eSpark-Backup/ptec-waterdispensingsystem/README.md

# PTEC - Water Dispensing System
The Water Dispensing System is essentially a circuit that will be installed water tanks and will enable the vendor to ensure correct delivery of water to the actual customer and will also measure the amount of water delivered. It will also be responsible to sync with cloud for customer verification and water dispensing statuses.

## Project Requirements
### Documents
#### [Complete Project Description](https://github.com/eSpark-Consultants/ptec-waterdispensingsystem/blob/main/docs/Upwork%20Project%20Description.pdf)
#### [Scope of Work Document](https://github.com/eSpark-Consultants/ptec-waterdispensingsystem/blob/main/docs/Modified%20Scope.pdf)
### Additional Points
* Our work scope will be limited to only designing circuit 2 in the Scope of Work Document
* All parts selection and engineering will be done by eSpark and client will review at the end. No parts selection is done by client.
* We need to take into account the humid and harsh conditions where this circuit will be placed and hence do parts selection accordingly.
* Circuit 2 will communicate with Circuit 1 over RS485 so necessary conversion should be given on Circuit 2.
* There will also be an LCD display on circuit 2 to display messages and notifications.
