eSpark-Backup/ptec-waterdispensingsystem/Deliverables/TFT-LCD-Side-PCB-v1.0/Renderings/2D_Bottom_View.PNG.png

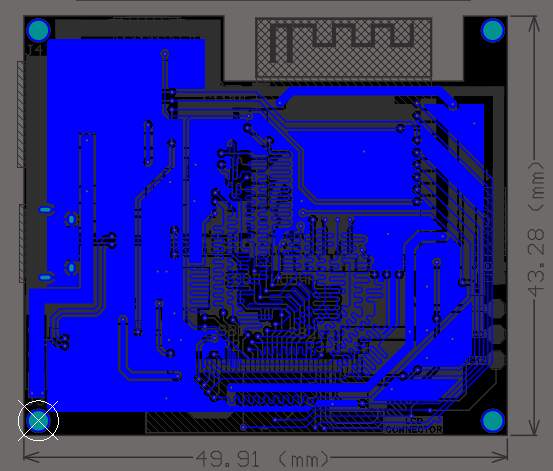
Deliverables/TFT-LCD-Side-PCB-v1.0/Renderings/2D_Bottom_View.PNG.png
