eSpark-Backup/ptec-waterdispensingsystem/Design Files/Main-PCB-v1.0/BOM/JLCPCB_BOM_v1.0.xlsx

Comment | Designator | Footprint | LCSC Part Number
CC0805KKX5R9BB225 | C1, C13, C25, C27 | Cap-0805 | C326581
CC0603KRX5R9BB104 | C2, C3, C10, C14, C16, C23, C24, C26, C32, C36, C37, C38, C42, C43, C44 | Cap-0603 | C386152
CC0603KRX5R6BB106 | C4, C6, C8, C18, C20, C21 | Cap-0603 | C326057
CC0603KRX5R8BB225 | C5, C11 | CAP-0603 | C309478
CC0603JRNPO9BN103 | C7 | Cap-0603 | C389113
UUD1H101MNL1GS | C9 | Custom | C116241
CC0402KRX7R9BB103 | C12, C15 | Cap-0402 | C60133
VUA270M1VTR-0606 | C17, C19 | Custom | C249807
CA45-A-10V-10uF-K | C22 | Custom | C128253
CC0603JRNPO9BN200 | C28, C29 | Cap-0603 | C105621
CC0603JRNPO9BN100 | C30, C31 | Cap-0603 | C106245
CC0402KRX5R7BB223 | C33, C34, C35, C39, C40, C41 | Cap-0402 | C147651
SK104C | D1 | SMC | C59500
SMBJ36CA | D2 | SMB_ | C556189
SK220-LTP | D3 | SMB_ | C725397
1N4148W-7-F | D4, D5, D6, D16, D17, D18 | SOD-123 | C83528
SMAJ6.5CA | D7, D8, D9, D10, D11, D12, D13, D14, D15, D19, D20, D21, D22, D23, D24, D25, D26, D27 | SMA | C83330
SHV2920P500-30-AA | F1 | Fuse-2920 | C495350
MF-MSMF010-2 | F2, F3, F4, F5, F6, F7, F8, F9, F10, F11, F12, F13 | Fuse-1812_ | C12430
B4B-XH-A(LF)(SN) | J2, J3, J4 | Custom | C144395
61300611121 | J5 | Custom | C37208
KH-2.54FH-1X8P-H8.5 | J6 | Custom | C2905417
B-2200S20P-A120 | J7 | Custom | C124410
JL762B-76202GA1 | J8, J9, J10, J11, J12, J13, J14, J15, J16, J17 | Custom | C394551
WJ500V-5.08-2P | J18 | Custom | C8465
1.25-5PWB | J19 | Custom | C2905012
YPRH1204-220M | L1 | Custom | C338845
YPRH1508-330M | L2 | Custom | C970542
SWPA8040S100MT | L3 | Custom | C37429
NCD0603G2 | LED1, LED2, LED3, LED4, LED5, LED6, LED7, LED8, LED9, LED10, LED11, LED12 | LED-0603 | C87326
PRT-10474 | P1 | Custom
3313J-1-103E | PT1 | Custom | C124616
RT0805BRD07422KL | R1 | RES-0805 | C865483
RT0402BRD0722K1L | R2, R4 | Res-0402 | C852648
RT0402BRD07162KL | R3 | Res-0402 | C852551
RT0402BRD0718K7L | R5 | Res-0402 | C723581
RT0402BRD076K98L | R6 | Res-0402 | C852901
RC0402FR-071KL | R7 | Res-0402 | C144789
RC0402FR-0710KL | R8, R15, R16, R23 | Res-0402 | C60490
RC0402FR-070RL | R9, R10, R11, R12, R13, R14, R17, R18, R19, R20, R21, R22, R36, R37, R38, R40, R42, R44, R45, R46, R47, R69, R70, R71, R73, R75, R77, R78, R79, R80 | Res-0402 | C106231
RC0402FR-074K7L | R24, R25, R26, R39, R41, R43, R51, R52, R53, R54, R55, R56, R57, R58, R59, R72, R74, R76, R84, R85, R86, R87, R88, R89 | Res-0402 | C105871
RC0402FR-072K4L | R27, R28, R29, R30, R31, R32, R60, R61, R62, R63, R64, R65 | Res-0402 | C112296
RC0402FR-0756KL | R33, R34, R35, R66, R67, R68 | Res-0402 | C114756
RC0603FR-07120RL | R48, R49, R50, R81, R82, R83 | Res-0603 | C114640
TS-1109S-C-B | SW1, SW2 | Custom | C381037
LMR51420YDDCR | U1, U4 | SOT-23-6 THIN | C5383002
SPX3819M5-L-3-3/TR | U2 | SOT-23-5 | C9055
LM2679SX-ADJ/NOPB | U3 | TO-263-7 | C2877272
STM32F413VGT6 | U5 | LQFP-100 | C1337293
TXB0108PWR | U6, U7 | TSSOP-20 | C53406
SN74HC04NSR | U8, U9, U10, U14, U15, U16 | 14-SOIC | C6812
SP3485EIM/TR | U11, U12, U13, U17, U18, U19 | SOP-8 | C519086
X322516MLB4SI | X1 | SMD3225-4P | C13738
NX3215SA-32.768K-STD-MUA-14 | X2 | Custom | C156244
