eSpark-Backup/ptec-waterdispensingsystem/Design Files/Main-PCB-v1.0/BOM/Client_BOM_v1.0.xlsx

 |  | Component list |  | Bill of Materials for Project [Main-PCB-v1.0.]
 |  | Source Data From: |  | Main-PCB-v1.0
 |  | Project: |  | Main-PCB-v1.0
 |  | Variant: |  | None
# | Item Type | Designator | Description | Footprint | Manufacturer Part Number | Alternate Part Number | Manufacturer | Value | Quantity | Remarks
1 | Capacitor | C1, C13, C25, C27 | CAP CER 2.2UF 50V X5R 0805 | Cap-0805 | CC0805KKX5R9BB225 | - | Yageo | 2.2uF | 4
2 | Capacitor | C2, C3, C10, C14, C16, C23, C24, C26, C32, C36, C37, C38, C42, C43, C44 | CAP CER 0.1UF 50V X5R 0603 | Cap-0603 | CC0603KRX5R9BB104 | - | Yageo | 100nF | 15
3 | Capacitor | C4, C6, C8, C18, C20, C21 | CAP CER 10UF 10V X5R 0603 | Cap-0603 | CC0603KRX5R6BB106 | - | Yageo | 10uF | 6
4 | Capacitor | C5, C11 | CAP CER 2.2UF 25V X5R 0603 | CAP-0603 | CC0603KRX5R8BB225 | - | Yageo | 2.2uF | 2
5 | Capacitor | C7 | CAP CER 10000PF 50V C0G/NPO 0603 | Cap-0603 | CC0603JRNPO9BN103 | - | Yageo | 10nF | 1
6 | Capacitor | C9 | CAP ALUM 100UF 20% 50V SMD | Custom | UUD1H101MNL1GS | - | Nichicon | 100uF | 1
7 | Capacitor | C12, C15 | CAP CER 10000PF 50V X7R 0402 | Cap-0402 | CC0402KRX7R9BB103 | - | Yageo | 10nF | 2
8 | Capacitor | C17, C19 | 27uF 35V ±20% SMD,D6.3xL5.7mm Aluminum Electrolytic Capacitors - SMD ROHS | Custom | VUA270M1VTR-0606 | - | Lelon | 27uF | 2
9 | Capacitor | C22 | 10uF 10V 8Ω@100kHz ±10% CASE-A-3216 Tantalum Capacitors ROHS | Custom | CA45-A-10V-10uF-K | - | CEC(Shenzhen Zhenhua XinYun Elec) | 10uF | 1
10 | Capacitor | C28, C29 | CAP CER 20PF 50V C0G/NPO 0603 | Cap-0603 | CC0603JRNPO9BN200 | - | Yageo | 20pF | 2
11 | Capacitor | C30, C31 | CAP CER 10PF 50V C0G/NPO 0603 | Cap-0603 | CC0603JRNPO9BN100 | - | Yageo | 10pF | 2
12 | Capacitor | C33, C34, C35, C39, C40, C41 | CAP CER 0.022UF 16V X5R 0402 | Cap-0402 | CC0402KRX5R7BB223 | - | Yageo | 22nF | 6
13 | Diode | D1 | 40V 650mV@10A 10A SMC(DO-214AB) Schottky Barrier Diodes (SBD) ROHS | SMC | SK104C | - | MDD | - | 1
14 | Diode | D2 | 58.1V 40V 36V Bi-Directional SMB(DO-214AA) TVS ROHS | SMB_ | SMBJ36CA | - | Slkor(SLKORMICRO Elec.) | - | 1
15 | Diode | D3 | 200V 900mV@2A 2A SMB(DO-214AA) Schottky Barrier Diodes (SBD) ROHS | SMB_ | SK220-LTP | - | MCC | - | 1
16 | Diode | D4, D5, D6, D16, D17, D18 | DIODE GEN PURP 100V 300MA SOD123 | SOD-123 | 1N4148W-7-F | - | Diodes | - | 6
17 | Diode | D7, D8, D9, D10, D11, D12, D13, D14, D15, D19, D20, D21, D22, D23, D24, D25, D26, D27 | TVS DIODE 6.5VWM 11.2VC DO214AC | SMA | SMAJ6.5CA | - | Littelfuse | - | 18
18 | Fuse | F1 | 30V 5A 5A 2920 Resettable Fuses ROHS | Fuse-2920 | SHV2920P500-30-AA | - | PTTC(Polytronics Tech) | - | 1
19 | Fuse | F2, F3, F4, F5, F6, F7, F8, F9, F10, F11, F12, F13 | 60V 100mA 40A 300mA 1812 Resettable Fuses ROHS | Fuse-1812_ | MF-MSMF010-2 | - | Bourns | - | 12
20 | THrough Hole Pads | J1 | Wire Connecting Pad | Custom | 2P THrough Hole Pads | - | - | - | 1
21 | JST Connector | J2, J3, J4 | CONN HEADER VERT 4POS 2.5MM | Custom | B4B-XH-A(LF)(SN) | - | JST | - | 3
22 | Header | J5 | CONN HEADER 6 POS 2.54 | Custom | 61300611121 | - | Wurth Electronics | - | 1
23 | Header | J6 | 2.54mm Plugin 3A -40℃~+105℃ Straight 1x8P 8.5mm Top 8 Square Holes Plugin,P=2.54mm Female Headers ROHS | Custom | KH-2.54FH-1X8P-H8.5 | - | Shenzhen Kinghelm Elec | - | 1
24 | Header | J7 | 2.54mm Plugin Brass Straight 1x20P 20 Plugin,P=2.54mm Female Headers ROHS | Custom | B-2200S20P-A120 | - | Ckmtw(Shenzhen Cankemeng) | - | 1
25 | Terminal Block | J8, J9, J10, J11, J12, J13, J14, J15, J16, J17 | -40℃~+105℃ 20A 300V Green Corner pin Double - Walled(Double) 14~22 Straight pin 2 1 7.62mm Plugin,P=7.62mm Barrier Terminal Blocks ROHS | Custom | JL762B-76202GA1 | - | JILN | - | 10
26 | Terminal Block | J18 | 2.5 18A Green Straight pin 5.08mm 1 14~30 2 Straight,P=5.08mm | Custom | WJ500V-5.08-2P | - | Ningbo Kangnex Elec | - | 1
27 | JST Right Angle | J19 | 1x5P 1 1.25mm Male pin 5 -25℃~+85℃ Surface Mount SMD,P=1.25mm Wire To Board / Wire To Wire Connector ROHS | Custom | 1.25-5PWB | - | DEALON | - | 1
28 | Inductor | L1 | 2.9A 22uH ±20% 66mΩ SMD,12x12x5mm Power Inductors ROHS | Custom | YPRH1204-220M | - | YJYCOIN | 22UH | 1
29 | Inductor | L2 | 6A 33uH ±20% SMD,15x15x8mm Power Inductors ROHS | Custom | YPRH1508-330M | - | YJYCOIN | 33uH | 1
30 | Inductor | L3 | Fixed Ind 1020%UH 0.029 Ohm 4100M | Custom | SWPA8040S100MT | - | Sunlord | 10uH | 1
31 | LED | LED1, LED2, LED3, LED4, LED5, LED6, LED7, LED8, LED9, LED10, LED11, LED12 | Emerald 0603 Light Emitting Diodes (LED) ROHS | LED-0603 | NCD0603G2 | - | Foshan NationStar Optoelectronics | - | 12
32 | Connector | P1 | XT60 CONNECTORS MALE/FEMALE PAIR | Custom | PRT-10474 | - | SparkFun | - | 1
33 | Potentiometer | PT1 | TRIMMER 10KOHM 0.125W J LEAD TOP | Custom | 3313J-1-103E | - | Bourns | 10K | 1
34 | Resistor | R1 | RES SMD 422K OHM 0.1% 1/8W 0805 | RES-0805 | RT0805BRD07422KL | - | Yageo | 422k | 1
35 | Resistor | R2, R4 | RES SMD 22.1KOHM 0.1% 1/16W 0402 | Res-0402 | RT0402BRD0722K1L | - | Yageo | 22.1K | 2
36 | Resistor | R3 | RES SMD 162K OHM 0.1% 1/16W 0402 | Res-0402 | RT0402BRD07162KL | - | Yageo | 162k | 1
37 | Resistor | R5 | RES SMD 18.7KOHM 0.1% 1/16W 0402 | Res-0402 | RT0402BRD0718K7L | - | Yageo | 18.7K | 1
38 | Resistor | R6 | RES SMD 6.98KOHM 0.1% 1/16W 0402 | Res-0402 | RT0402BRD076K98L | - | Yageo | 6.98K | 1
39 | Resistor | R7 | RES 1K OHM 1% 1/16W 0402 | Res-0402 | RC0402FR-071KL | - | Yageo | 1K | 1
40 | Resistor | R8, R15, R16, R23 | RES 10K OHM 1% 1/16W 0402 | Res-0402 | RC0402FR-0710KL | - | Yageo | 10K | 4
41 | Resistor | R9, R10, R11, R12, R13, R14, R17, R18, R19, R20, R21, R22, R36, R37, R38, R40, R42, R44, R45, R46, R47, R69, R70, R71, R73, R75, R77, R78, R79, R80 | RES 0 OHM JUMPER 1/16W 0402 | Res-0402 | RC0402FR-070RL | - | Yageo | 0R | 30
42 | Resistor | R24, R25, R26, R39, R41, R43, R51, R52, R53, R54, R55, R56, R57, R58, R59, R72, R74, R76, R84, R85, R86, R87, R88, R89 | RES 4.7K OHM 1% 1/16W 0402 | Res-0402 | RC0402FR-074K7L | - | Yageo | 4.7K | 24
43 | Resistor | R27, R28, R29, R30, R31, R32, R60, R61, R62, R63, R64, R65 | RES 2.4K OHM 1% 1/16W 0402 | Res-0402 | RC0402FR-072K4L | - | Yageo | 2.4k | 12
44 | Resistor | R33, R34, R35, R66, R67, R68 | RES 56K OHM 1% 1/16W 0402 | Res-0402 | RC0402FR-0756KL | - | Yageo | 56k | 6
45 | Resistor | R48, R49, R50, R81, R82, R83 | RES 120 OHM 1% 1/10W 0603 | Res-0603 | RC0603FR-07120RL | - | Yageo | 120R | 6
46 | Solder Bridge | SB1, SB2, SB3, SB4, SB5, SB6, SB7, SB8, SB9, SB10, SB11, SB12, SB13, SB14, SB15, SB16, SB17, SB18, SB19, SB20 | Solder Bridge ON | Solder Bridge 0402 | Solder Bridge 0402 | - | - | - | 20
47 | Switch | SW1, SW2 | No NO 50mA 4.5mm 100000 260gf 12V -30℃~+85℃ 4.5mm 4.3mm Black Round Button Brick nogging SPST SMD Tactile Switches ROHS | Custom | TS-1109S-C-B | - | XKB Connectivity | - | 2
48 | IC | U1, U4 | IC REG BUCK ADJ 2A SOT23-THIN | SOT-23-6 THIN | LMR51420YDDCR | - | Texas Instruments | - | 2
49 | IC | U2 | SPX3819 Series 3.3 V 500 mA Fixed Output SMT LDO Regulator - SOT-23-5 | SOT-23-5 | SPX3819M5-L-3-3/TR | - | MaxLinear | - | 1
50 | IC | U3 | IC REG BUCK ADJ 5A TO263-7 | TO-263-7 | LM2679SX-ADJ/NOPB | - | TI National Semiconductor | - | 1
51 | IC | U5 | MCU 32-bit ARM Cortex M4 RISC 1MB Flash 3.3V 100-Pin LQFP Frame | LQFP-100 | STM32F413VGT6 | - | STMicroelectronics | - | 1
52 | IC | U6, U7 | IC 8-BIT TRNSTR 15KV ESD 20TSSOP | TSSOP-20 | TXB0108PWR | - | Texas Instruments | - | 2
53 | IC | U8, U9, U10, U14, U15, U16 | 6 16ns@6V,50pF 2uA 2V~6V SOIC-14-208mil Inverters ROHS | 14-SOIC | SN74HC04NSR | - | Texas Instruments | - | 6
54 | IC | U11, U12, U13, U17, U18, U19 | SOP-8 RS-485/RS-422 ICs ROHS | SOP-8 | SP3485EIM/TR | - | HGSEMI | - | 6
55 | Crystal | X1 | 16MHz SMD Crystal Resonator 9pF ±10ppm ±30ppm -40℃~+85℃ SMD3225-4P Crystals ROHS | SMD3225-4P | X322516MLB4SI | - | Yangxing Tech | - | 1
56 | Crystal | X2 | CRYSTAL 32.7680KHZ 6PF SMD | Custom | NX3215SA-32.768K-STD-MUA-14 | - | NDK | - | 1
57 | Peripheral | - | Flowmeter | - | UF2000F | - | HLOYKELL | - | 1
58 | Peripheral | - | Electric Valve | - | DN50 | - | MIT-UNID-CNS | - | 1
59 | Peripheral | - | RFID Reader | - | RS485 | - | HZCCXZ-RFID-CARD | - | 1
60 | Peripheral | - | Keypad | - | K-TEK-A120KP-BL-DWP | - | key-tek | - | 1
61 | Peripheral | - | Thermal Printer | - | Metal Thermal PPanel Mount Printer | - | MASUNG | - | 1
62 | Peripheral | - | Push Buttons | - | Push Button Switch with Light | - | Sweideer | - | 1
63 | Peripheral | - | LED Display smaller size | - | NHD-12864WG-CTFH-V#N | - | Newhaven | - | 1
64 | Peripheral | - | TDS Sensor | - | CCT-3320 CCT-3320C CCT-3320V | - | ROC | - | 1
