eSpark-Backup/ptec-waterdispensingsystem/Design Files/TFT-LCD-Side-PCB-v1.0/BOM/Client-BOM.xlsx

 |  | Component list |  | Bill of Materials for Project [TFT-LCD-Side-PCB-v1.0.]
 |  | Source Data From: |  | TFT-LCD-Side-PCB-v1.0.
 |  | Project: |  | TFT-LCD-Side-PCB-v1.0.
 |  | Variant: |  | None
# | Item Type | Designator | Description | Footprint | Manufacturer Part Number | Alternate Part Number | Manufacturer | Value | Quantity | Quantity (5 Boards) | Remarks
1 | Capacitor | C1, C9, C13 | CAP CER 1UF 25V X5R 0402 | Cap-0402 | CC0402KRX5R8BB105 | - | Yageo | 1uF | 3 | 15
2 | Capacitor | C2 | CAP TANT 100UF 20% 25V 2917 | Case-E | TAJE107M025RNJ | - | Kyocera AVX | 100uF | 1 | 5
3 | Capacitor | C3, C4, C5, C12 | CAP CER 0.1UF 25V X5R 0402 | Cap-0402 | CC0402KRX5R8BB104 | - | Yageo | 100nF | 4 | 20
4 | Capacitor | C6, C10 | CAP CER 2.2UF 25V X5R 0603 | Cap-0603 | CC0603KRX5R8BB225 | - | Yageo | 2.2uF | 2 | 10
5 | Capacitor | C7 | CAP CER 10000PF 50V C0G/NPO 0603 | Cap-0603 | CC0603JRNPO9BN103 | - | Yageo | 10nF | 1 | 5
6 | Capacitor | C8, C11 | CAP CER 10UF 10V X5R 0402 | Cap-0402 | CC0402MRX5R6BB106 | - | Yageo | 10uF | 2 | 10
7 | Diode | D1 | TVS DIODE 5VWM 6.3VC DSN0603-2 | DSN0603-2 | PESD5V0H1BSFYL | - | Nexperia |  | 1 | 5
8 | Diode | D2, D4 | DIODE GEN PURP 100V 300MA SOD123 | SOD-123 | 1N4148W-7-F | - | Diodes |  | 2 | 10
9 | Diode | D3 | 16A 20V 7V 5V@Max Unidirectional SOT-23 TVS ROHS | Sot-23 | ESD5302F-3/TR | - | WILLSEMI |  | 1 | 5
10 | LED Connector | J1 | CONN FFC TOP 40POS 0.50MM R/A | Custom | FH12A-40S-0.5SH(55) | - | Hirose |  | 1 | 5
11 | USB Connector | J2 | CONN RCPT USB2.0 MICRO B SMD R/A | Custom | 10118194-0001LF | - | Amphenol FCI |  | 1 | 5
12 | Pogo Connector | J3 | Pogo Pad 2.5mm 4 Pin | Custom | POGO Connector 4 Pin | - |  |  | 1 | 5
13 | JST Right Angle | J4 | 1x5P 1 1.25mm Male pin 5 -25℃~+85℃ Surface Mount SMD,P=1.25mm Wire To Board / Wire To Wire Connector ROHS | Custom | 1.25-5PWB | - | DEALON |  | 1 | 5
14 | Inductor | L1 | 1.55A 4.7uH ±20% SMD Power Inductors ROHS | Custom | SLO252012F4R7MTT | - | Sunltech Tech | 4.7uH | 1 | 5
15 | LED | LED1 | yellow 0603 Light Emitting Diodes (LED) ROHS | LED-0603 | NCD0603Y2 | - | Foshan NationStar Optoelectronics |  | 1 | 5
16 | ~~TEST POINT~~ | ~~P1, P2, P3~~ | ~~Test Point ON~~ | ~~Custom~~ | ~~-~~ | ~~-~~ | - |  | 3 | 15
17 | Resistor | R1 | RES 0 OHM JUMPER 1/10W 0603 | Res-0603 | RC0603JR-070RL | - | Yageo | 0R | 1 | 5
18 | Resistor | R2, R3, R4, R7, R9, R10 | RES SMD 10K Ohm 1% 1/10W 0603 | Res-0603 | RC0603FR-0710KL | - | Yageo | 10K | 6 | 30
19 | Resistor | R5 | RES 2.7 OHM 1% 1/10W 0603 | Res-0603 | RC0603FR-072R7L | - | Yageo | 2.7R | 1 | 5
20 | Resistor | R6 | RES 133 OHM 1% 1/16W 0402 | Res-0402 | RC0402FR-07133RL | - | Yageo | 133R | 1 | 5
21 | Resistor | R8 | RES 100 OHM 1% 1/16W 0402 | Res-0402 | RC0402FR-07100RL | - | Yageo | 100R | 1 | 5
22 | ~~Solder Bridge~~ | ~~SB1, SB2~~ | ~~Solder Bridge ON~~ | ~~Custom~~ | ~~Solder Bridge 0402~~ | ~~-~~ |  |  | 2 | 10
23 | Switch | SW1, SW2 | No NO 50mA 4.5mm 100000 260gf 12V -30℃~+85℃ 4.5mm 4.3mm Black Round Button Brick nogging SPST SMD Tactile Switches ROHS | Custom | TS-1109S-C-B | - | XKB Connectivity |  | 2 | 10
24 | Module | U1 | SMD MODULE, ESP32-S3R8 WITH 3.3V | Custom | ESP32-S3-WROOM-1-N16R8 | - | Espressif Systems |  | 1 | 5
25 | IC | U2 | SPX3819 Series 3.3 V 500 mA Fixed Output SMT LDO Regulator - SOT-23-5 | SOT-23-5 | SPX3819M5-L-3-3/TR | - | MaxLinear |  | 1 | 5
26 | IC | U3 | IC LED DRVR RGLTR PWM SOT23-6 | SOT-23-6 | AP3019AKTR-G1 | - | Diodes |  | 1 | 5
27 | Peripheral | - | LED Display smaller size | - | 480x480 TFT LCD |  | DWS | - | 1 | 5
28 | Peripheral | - | - | - | LDR125-157128-150-5P |  | DEALON | - | 1 | 5
