eSpark-Backup/ptec-waterdispensingsystem/Design Files/TFT-LCD-Side-PCB-v1.0/BOM/eSpark_BOM-v1.0.xlsx

 |  | Component list |  | Bill of Materials for Project [TFT-LCD-Side-PCB-v1.0.]
 |  | Source Data From: |  | TFT-LCD-Side-PCB-v1.0.
 |  | Project: |  | TFT-LCD-Side-PCB-v1.0.
 |  | Variant: |  | None
# | Item Type | Designator | Description | Footprint | Manufacturer Part Number | Manufacturer | Alternate Part Number | LCSC Part Number | Value | Quantity | Quantity (5 Boards) | MOQ (5 Boards) | Links | Unit Cost (5 Boards) | Total Cost (5 Boards) | Remarks | Reviewer Remarks
1 | Capacitor | C1, C9, C13 | CAP CER 1UF 25V X5R 0402 | Cap-0402 | CC0402KRX5R8BB105 | Yageo | - | C326568 | 1uF | 3 | 15 | 50 | LCSC (https://www.lcsc.com/product-detail/Multilayer-Ceramic-Capacitors-MLCC-SMD-SMT_YAGEO-CC0402KRX5R8BB105_C326568.html) | $0.0089 | $0.4450
2 | Capacitor | C2 | CAP TANT 100UF 20% 25V 2917 | Case-E | TAJE107M025RNJ | Kyocera AVX | - | C7230 | 100uF | 1 | 5 | 6 | LCSC (https://www.lcsc.com/product-detail/Tantalum-Capacitors_Kyocera-AVX-TAJE107M025RNJ_C7230.html) | $1.3523 | $8.1138
3 | Capacitor | C3, C4, C5, C12 | CAP CER 0.1UF 25V X5R 0402 | Cap-0402 | CC0402KRX5R8BB104 | Yageo | - | C106256 | 100nF | 4 | 20 | 100 | LCSC (https://www.lcsc.com/product-detail/Multilayer-Ceramic-Capacitors-MLCC-SMD-SMT_YAGEO-CC0402KRX5R8BB104_C106256.html) | $0.0019 | $0.1900
4 | Capacitor | C6, C10 | CAP CER 2.2UF 25V X5R 0603 | Cap-0603 | CC0603KRX5R8BB225 | Yageo | - | C309478 | 2.2uF | 2 | 10 | 50 | LCSC (https://www.lcsc.com/product-detail/Multilayer-Ceramic-Capacitors-MLCC-SMD-SMT_YAGEO-CC0603KRX5R8BB225_C309478.html) | $0.0185 | $0.9250
5 | Capacitor | C7 | CAP CER 10000PF 50V C0G/NPO 0603 | Cap-0603 | CC0603JRNPO9BN103 | Yageo | - | C389113 | 10nF | 1 | 5 | 50 | LCSC (https://www.lcsc.com/product-detail/Multilayer-Ceramic-Capacitors-MLCC-SMD-SMT_YAGEO-CC0603JRNPO9BN103_C389113.html) | $0.0149 | $0.7450
6 | Capacitor | C8, C11 | CAP CER 10UF 10V X5R 0402 | Cap-0402 | CC0402MRX5R6BB106 | Yageo | - | C962143 | 10uF | 2 | 10 | 20 | LCSC (https://www.lcsc.com/product-detail/Multilayer-Ceramic-Capacitors-MLCC-SMD-SMT_YAGEO-CC0402MRX5R6BB106_C962143.html) | $0.0244 | $0.4880
7 | Diode | D1 | TVS DIODE 5VWM 6.3VC DSN0603-2 | DSN0603-2 | PESD5V0H1BSFYL | Nexperia | - | C477989 | - | 1 | 5 | 10 | LCSC (https://www.lcsc.com/product-detail/ESD-Protection-Devices_Nexperia-PESD5V0H1BSF_C477989.html) | $0.0617 | $0.6170
8 | Diode | D2, D4 | DIODE GEN PURP 100V 300MA SOD123 | SOD-123 | 1N4148W-7-F | Diodes | - | C83528 | - | 2 | 10 | 20 | LCSC (https://www.lcsc.com/product-detail/Switching-Diode_Diodes-Incorporated-1N4148W-7-F_C83528.html) | $0.0105 | $0.2100
9 | Diode | D3 | 16A 20V 7V 5V@Max Unidirectional SOT-23 TVS ROHS | Sot-23 | ESD5302F-3/TR | WILLSEMI | - | C239643 | - | 1 | 5 | 10 | LCSC (https://www.lcsc.com/product-detail/TVS_WILLSEMI-Will-Semicon-ESD5302F-3-TR_C239643.html) | $0.0864 | $0.8640
10 | LED Connector | J1 | CONN FFC TOP 40POS 0.50MM R/A | Custom | FH12A-40S-0.5SH(55) | Hirose | - | C506795 | - | 1 | 5 | 6 | LCSC (https://www.lcsc.com/product-detail/FFC-FPC-Connectors_HRS-Hirose-FH12A-40S-0-5SH-55_C506795.html) | $0.8719 | $5.2314
11 | USB Connector | J2 | CONN RCPT USB2.0 MICRO B SMD R/A | Custom | 10118194-0001LF | Amphenol FCI | - | C132563 | - | 1 | 5 | 10 | LCSC (https://www.lcsc.com/product-detail/USB-Connectors_Amphenol-ICC-10118194-0001LF_C132563.html) | $0.2033 | $2.0330
12 | Pogo Connector | J3 | Pogo Pad 2.5mm 4 Pin | Custom | POGO Connector 4 Pin | - | - | - | - | 1 | 5 | - | - | - | -
13 | JST Right Angle | J4 | 1x5P 1 1.25mm Male pin 5 -25℃~+85℃ Surface Mount SMD,P=1.25mm Wire To Board / Wire To Wire Connector ROHS | Custom | 1.25-5PWB | DEALON | - | C2905012 | - | 1 | 5 | 10 | LCSC (https://www.lcsc.com/product-detail/Wire-To-Board-Wire-To-Wire-Connector_DEALON-1-25-5PWB_C2905012.html) | $0.0343 | $0.3430
14 | Inductor | L1 | 1.55A 4.7uH ±20% SMD Power Inductors ROHS | Custom | SLO252012F4R7MTT | Sunltech Tech | - | C275675 | 4.7uH | 1 | 5 | 10 | LCSC (https://www.lcsc.com/product-detail/Power-Inductors_Sunltech-Tech-SLO252012F4R7MTT_C275675.html) | $0.0730 | $0.7300
15 | LED | LED1 | yellow 0603 Light Emitting Diodes (LED) ROHS | LED-0603 | NCD0603Y2 | Foshan NationStar Optoelectronics | - | C89811 | - | 1 | 5 | 20 | LCSC (https://www.lcsc.com/product-detail/Light-Emitting-Diodes-LED_Foshan-NationStar-Optoelectronics-NCD0603Y2_C89811.html) | $0.0237 | $0.4740
16 | ~~TEST POINT~~ | ~~P1, P2, P3~~ | ~~Test Point ON~~ | ~~Custom~~ | ~~-~~ | ~~-~~ | ~~-~~ | ~~-~~ | ~~-~~ | ~~3~~ | ~~15~~ | ~~-~~ | ~~LCSC~~ | ~~-~~ | ~~-~~
17 | Resistor | R1 | RES 0 OHM JUMPER 1/10W 0603 | Res-0603 | RC0603JR-070RL | Yageo | - | C95177 | 0R | 1 | 5 | 100 | LCSC (https://www.lcsc.com/product-detail/Chip-Resistor-Surface-Mount_YAGEO-RC0603JR-070RL_C95177.html) | $0.0011 | $0.1100
18 | Resistor | R2, R3, R4, R7, R9, R10 | RES SMD 10K Ohm 1% 1/10W 0603 | Res-0603 | RC0603FR-0710KL | Yageo | - | C98220 | 10K | 6 | 30 | 100 | LCSC (https://www.lcsc.com/product-detail/Chip-Resistor-Surface-Mount_YAGEO-RC0603FR-0710KL_C98220.html) | $0.0010 | $0.1000
19 | Resistor | R5 | RES 2.7 OHM 1% 1/10W 0603 | Res-0603 | RC0603FR-072R7L | Yageo | - | C309560 | 2.7R | 1 | 5 | 100 | LCSC (https://www.lcsc.com/product-detail/Chip-Resistor-Surface-Mount_YAGEO-RC0603FR-072R7L_C309560.html) | $0.0032 | $0.3200
20 | Resistor | R6 | RES 133 OHM 1% 1/16W 0402 | Res-0402 | RC0402FR-07133RL | Yageo | - | C327373 | 133R | 1 | 5 | 100 | LCSC (https://www.lcsc.com/product-detail/Chip-Resistor-Surface-Mount_YAGEO-RC0402FR-07133RL_C327373.html) | $0.0008 | $0.0800
21 | Resistor | R8 | RES 100 OHM 1% 1/16W 0402 | Res-0402 | RC0402FR-07100RL | Yageo | - | C106232 | 100R | 1 | 5 | 100 | LCSC (https://www.lcsc.com/product-detail/Chip-Resistor-Surface-Mount_YAGEO-RC0402FR-07100RL_C106232.html) | $0.0007 | $0.0700
22 | ~~Solder Bridge~~ | ~~SB1, SB2~~ | ~~Solder Bridge ON~~ | ~~Custom~~ | ~~Solder Bridge 0402~~ | ~~-~~ | ~~-~~ | ~~-~~ | ~~-~~ | ~~2~~ | ~~10~~ | ~~-~~ | ~~-~~ | ~~-~~ | ~~-~~
23 | Switch | SW1, SW2 | No NO 50mA 4.5mm 100000 260gf 12V -30℃~+85℃ 4.5mm 4.3mm Black Round Button Brick nogging SPST SMD Tactile Switches ROHS | Custom | TS-1109S-C-B | XKB Connectivity | - | C381037 | - | 2 | 10 | 20 | LCSC (https://www.lcsc.com/product-detail/Tactile-Switches_XKB-Connectivity-TS-1109S-C-B_C381037.html) | $0.0213 | $0.4260
24 | Module | U1 | SMD MODULE, ESP32-S3R8 WITH 3.3V | Custom | ESP32-S3-WROOM-1-N16R8 | Espressif Systems | - | C2913202 |  | 1 | 5 | 6 | LCSC (https://www.lcsc.com/product-detail/WiFi-Modules_Espressif-Systems-ESP32-S3-WROOM-1-N16R8_C2913202.html) | $5.1180 | $30.7080
25 | IC | U2 | SPX3819 Series 3.3 V 500 mA Fixed Output SMT LDO Regulator - SOT-23-5 | SOT-23-5 | SPX3819M5-L-3-3/TR | MaxLinear | - | C9055 |  | 1 | 5 | 10 | LCSC (https://www.lcsc.com/product-detail/Linear-Voltage-Regulators-LDO_MaxLinear-SPX3819M5-L-3-3-TR_C9055.html) | $0.1620 | $1.6200
26 | IC | U3 | IC LED DRVR RGLTR PWM SOT23-6 | SOT-23-6 | AP3019AKTR-G1 | Diodes | - | C44956 |  | 1 | 5 | 10 | LCSC (https://www.lcsc.com/product-detail/LED-Drivers_Diodes-Incorporated-AP3019AKTR-G1_C44956.html) | $0.0708 | $0.7080
27 | Peripheral | - | LED Display smaller size | - | 480x480 TFT LCD | DWS | - | - | - | 1 | 5 | 2 | Aliexpress (https://vi.aliexpress.com/item/1005005230886441.html) | $12.0000 | $24.0000
28 | Peripheral | - | - | - | LDR125-157128-150-5P | DEALON | - | C2998976 | - | 1 | 5 | 6 | LCSC (https://www.lcsc.com/product-detail/Network-cables_DEALON-LDR125-157128-150-5P_C2998976.html) | $0.1117 | $0.6702
 |  |  |  |  |  |  |  |  |  |  |  | Total Component Cost |  |  | $55.55
 |  |  |  |  |  |  |  |  |  |  |  | Single Board Cost |  |  | $11.11
