eSpark-Backup/ptec-waterdispensingsystem/Deliverables/TFT-LCD-Side-PCB-v1.0/Supporting Files/Side_PCB.step

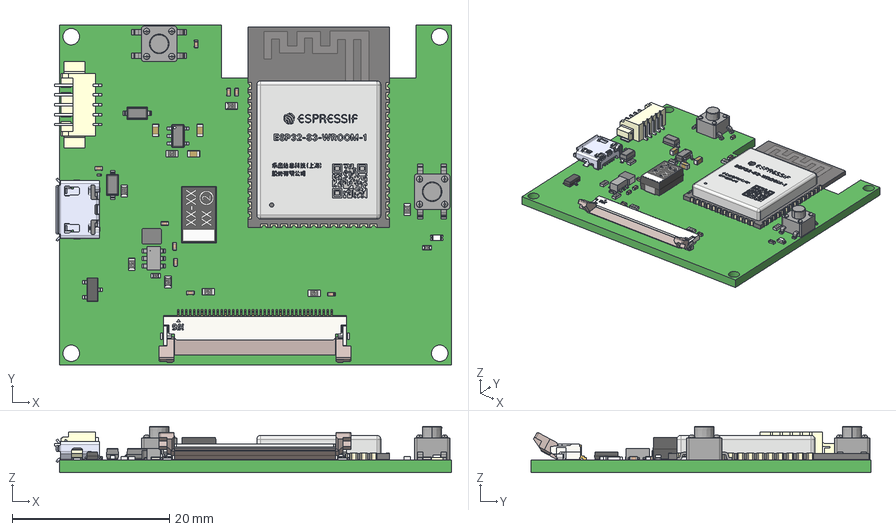
[picture p24: CAD file, 2023-06-15]
Deliverables/TFT-LCD-Side-PCB-v1.0/Supporting Files/Side_PCB.step
50.5 x 43.3 x 5.90 mm
User_Library-RESC1608X05N x 8
User_Library-Capacitor_0402 x 9
21-0058I_MXM
SN74LV1T34DBVR
ESP-S3-WROOM_via_v3 x 26
ESP32-S3-WROOM_shell_v11
ESP32-S3-WROOM_body_v12
ESP-S3-WROOM_via_v3(\X2\955C50CF\X0\) x 14
ts-1109s-c-b_RGB6710886 x 2
User_Library-RES_1005-0402 x 2
User_Library-LED_SMD0603
SLO252012F4R7MTT
1.25-5PWB
10118194-0001LF--3DModel-STEP-56544
FH12A-40S-0.5SH_\X\8A\X\C8\X\97\X\AA
Hirose_Logo_adjastable
1N5819HW-7-F--3DModel-STEP-56544 x 2
CircuitWorks-SOT-23
PESD5V0H1BSF
User_Library-CAPC1608X09 x 3
593D_D-CASE
