eSpark-Backup/ptec-waterdispensingsystem/(list of files, cad)

Other CAD files:
Deliverables/TFT-LCD-Side-PCB-v1.0/Supporting Files/Side_PCB.DWG
Deliverables/TFT-LCD-Side-PCB-v1.0/Supporting Files/Side_PCB.DXF
