eSpark-Backup/ptec-waterdispensingsystem/Design Files/Main-PCB-v1.0/Main-PCB-v1.0.pdf

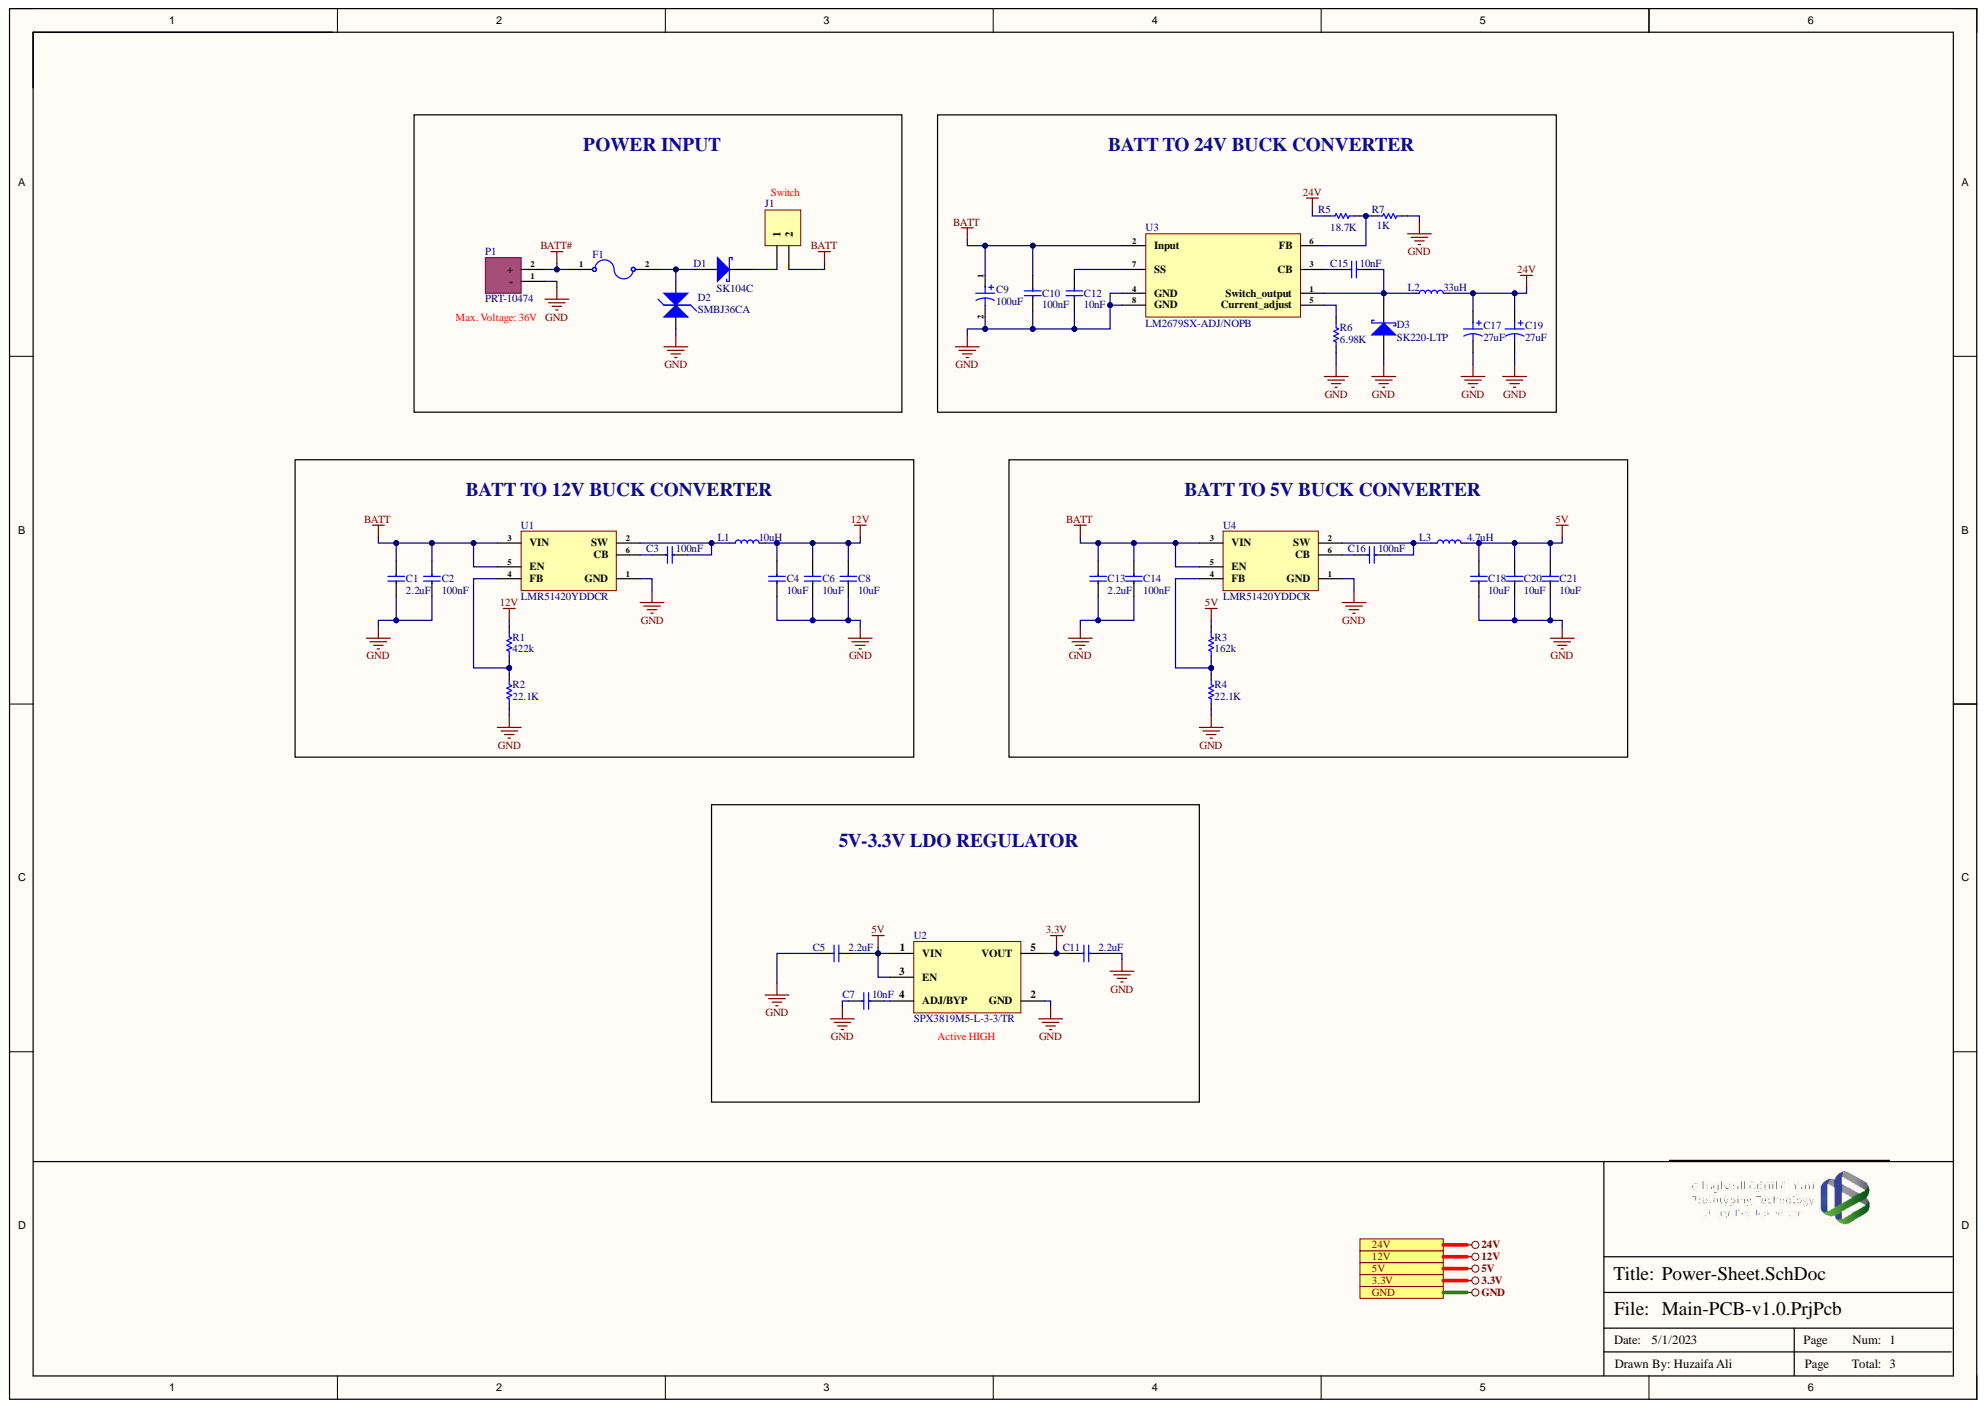
[picture p25: page 1]

BATT TO 24V BUCK CONVERTER

Date: 5/1/2023 | Page Num: 1

Drawn By: Huzaifa Ali | Page Total:

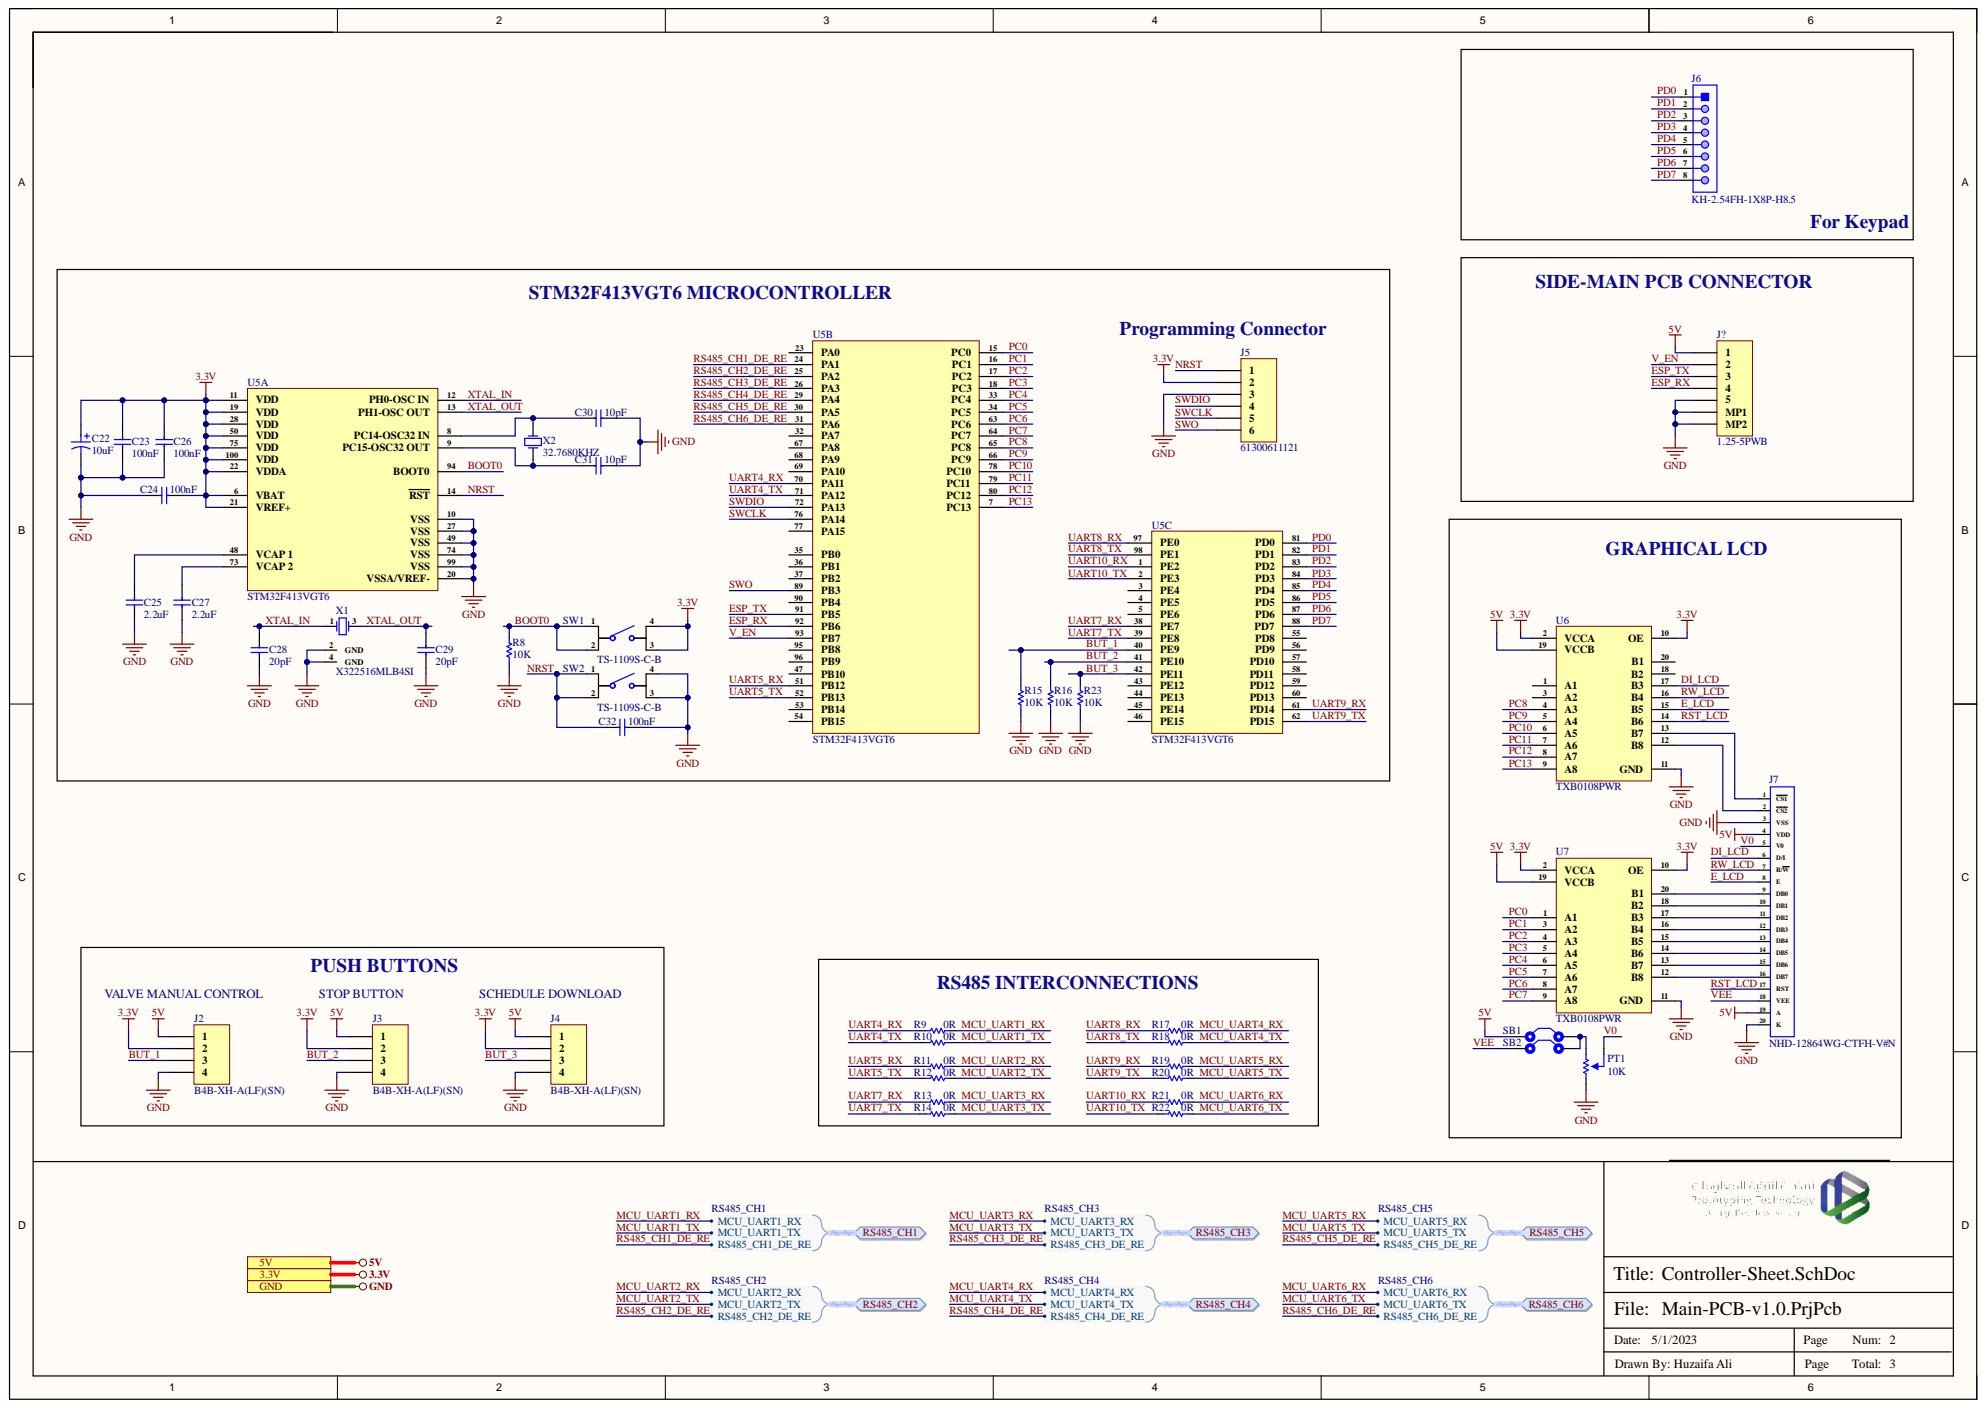
[picture p26: page 2]

SIDE-MAIN PCB CONNECTOR

VDDA 22 | BOOT0

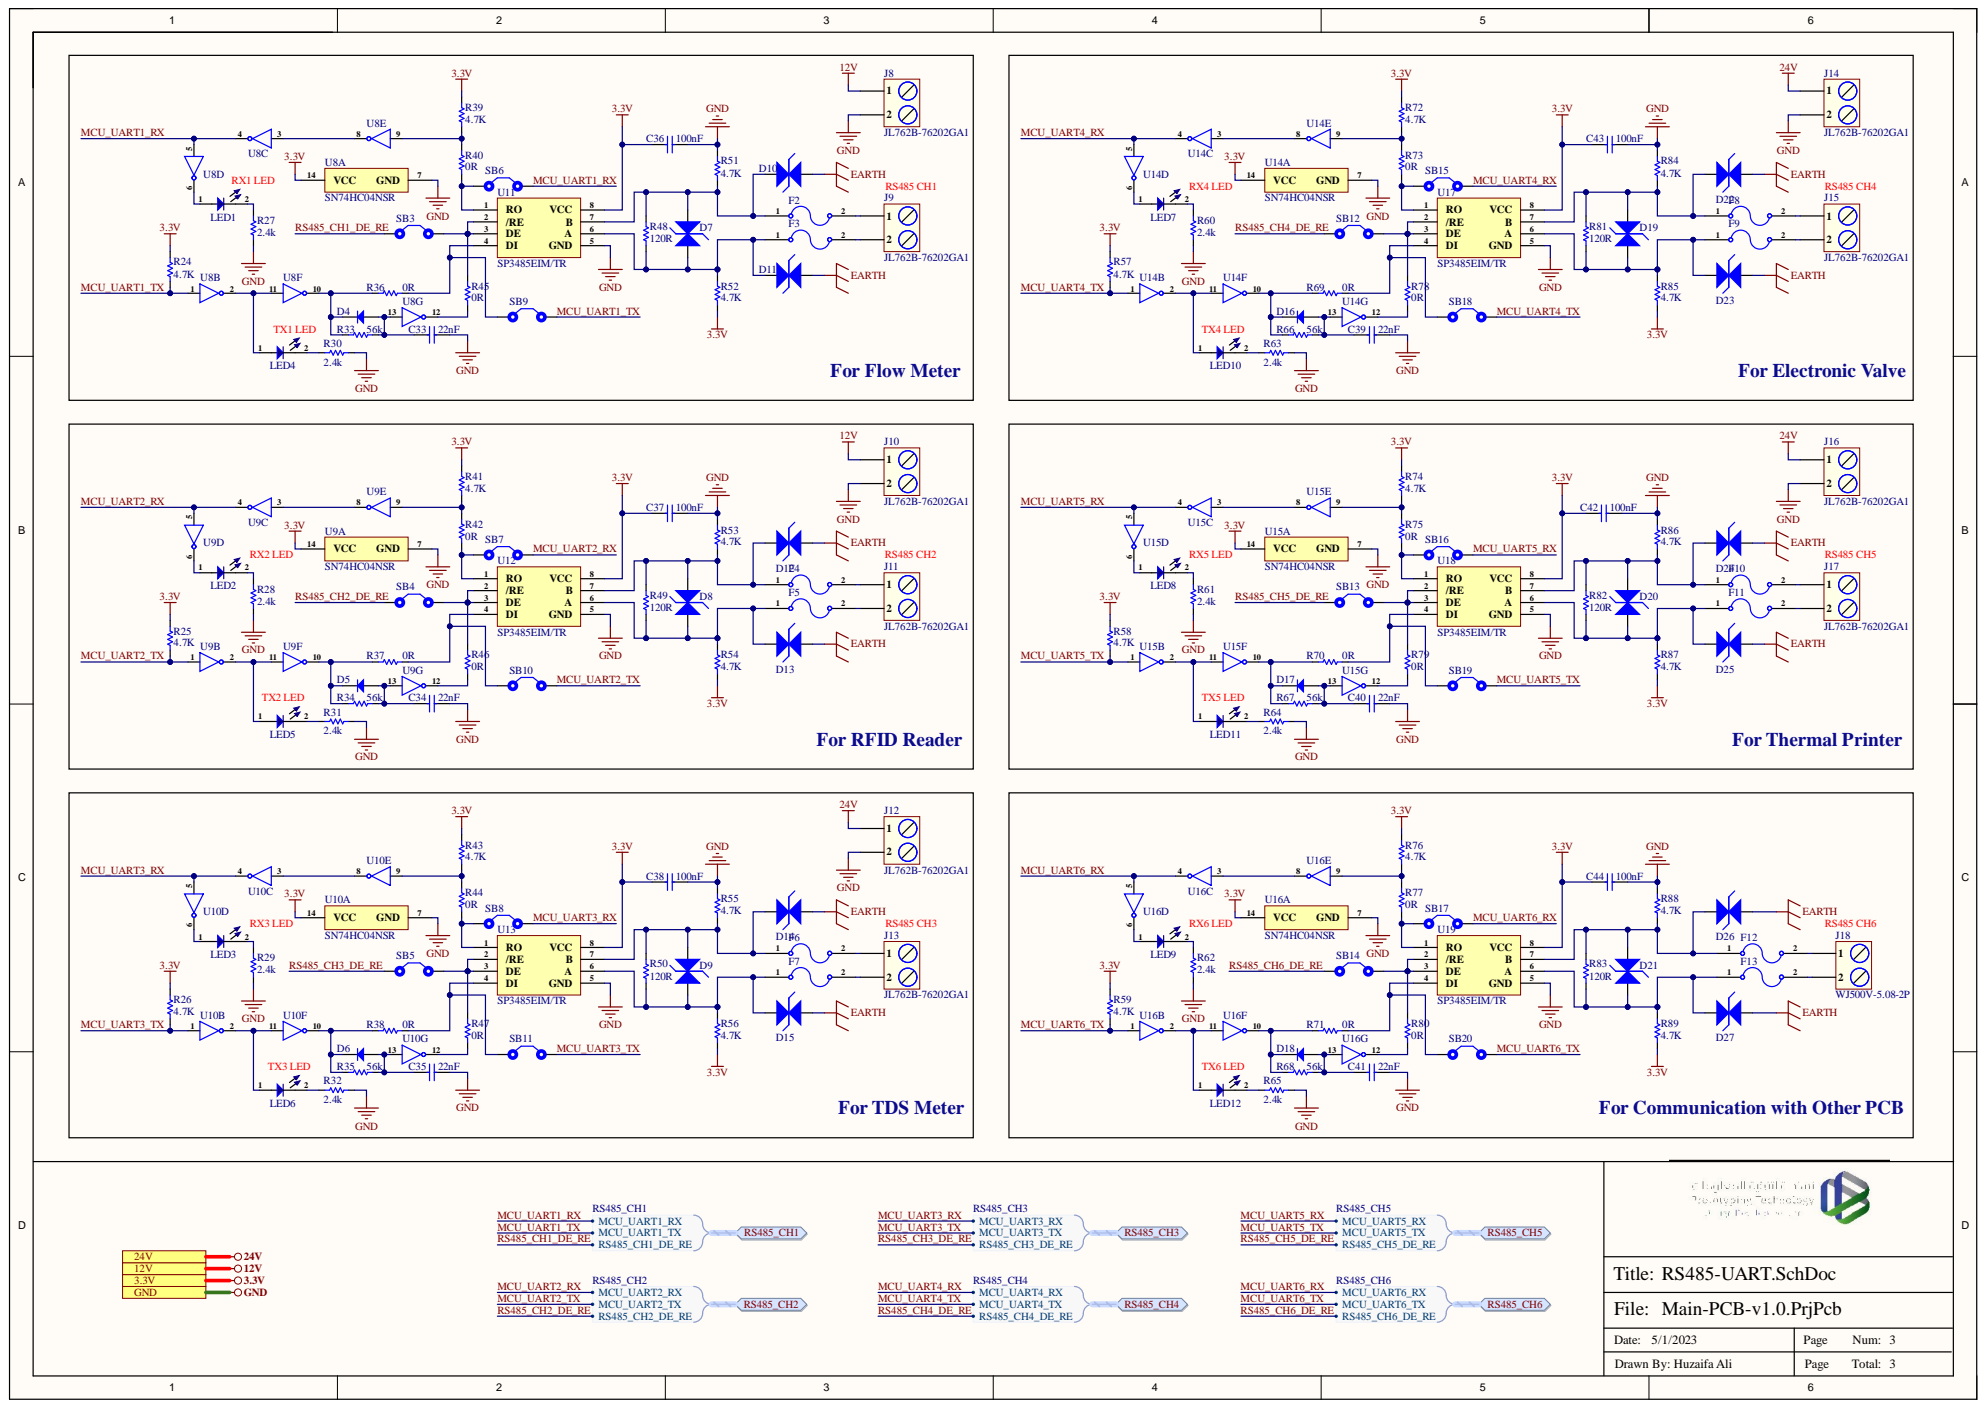
[picture p27: page 3]
