eSpark-Backup/ptec-waterdispensingsystem/Design Files/TFT-LCD-Side-PCB-v1.0/TFT-LCD-Side-PCB-v1.0.pdf

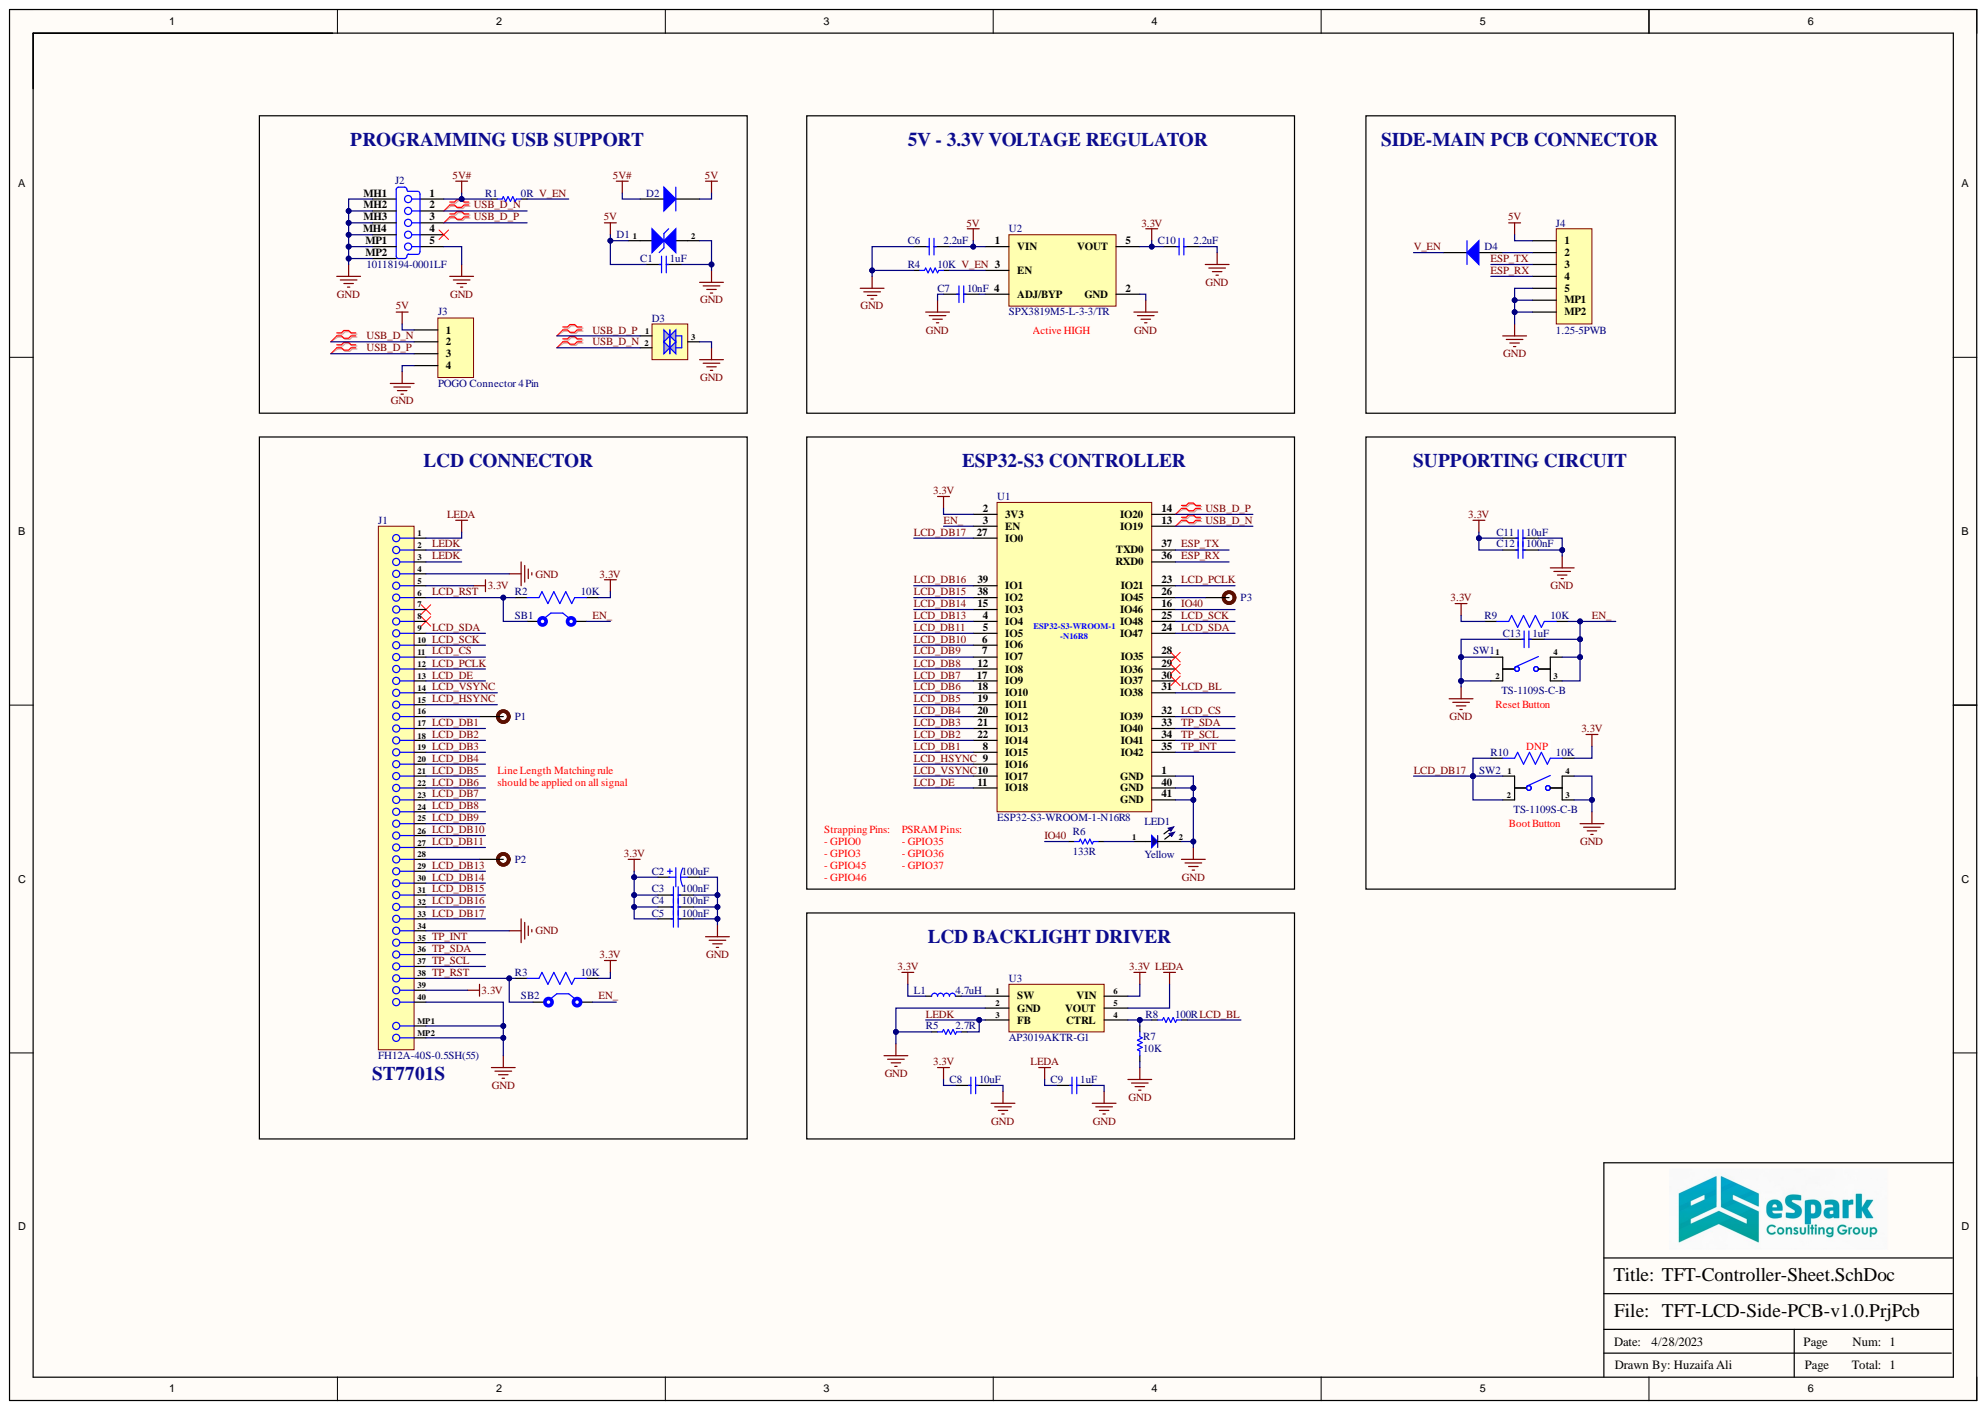
[picture p28: page 1]

Line Lengt
should be applied on all signal

LED K

Date : 4/2 8/2 0 2 3 | P a g e Nu m : 11

Drawn By: Hu z aifa Ali | P a g e T ota l :
