eSpark-Backup/ptec-waterdispensingsystem/Deliverables/TFT-LCD-Side-PCB-v1.0/Assembly/Assembly Drawings.pdf

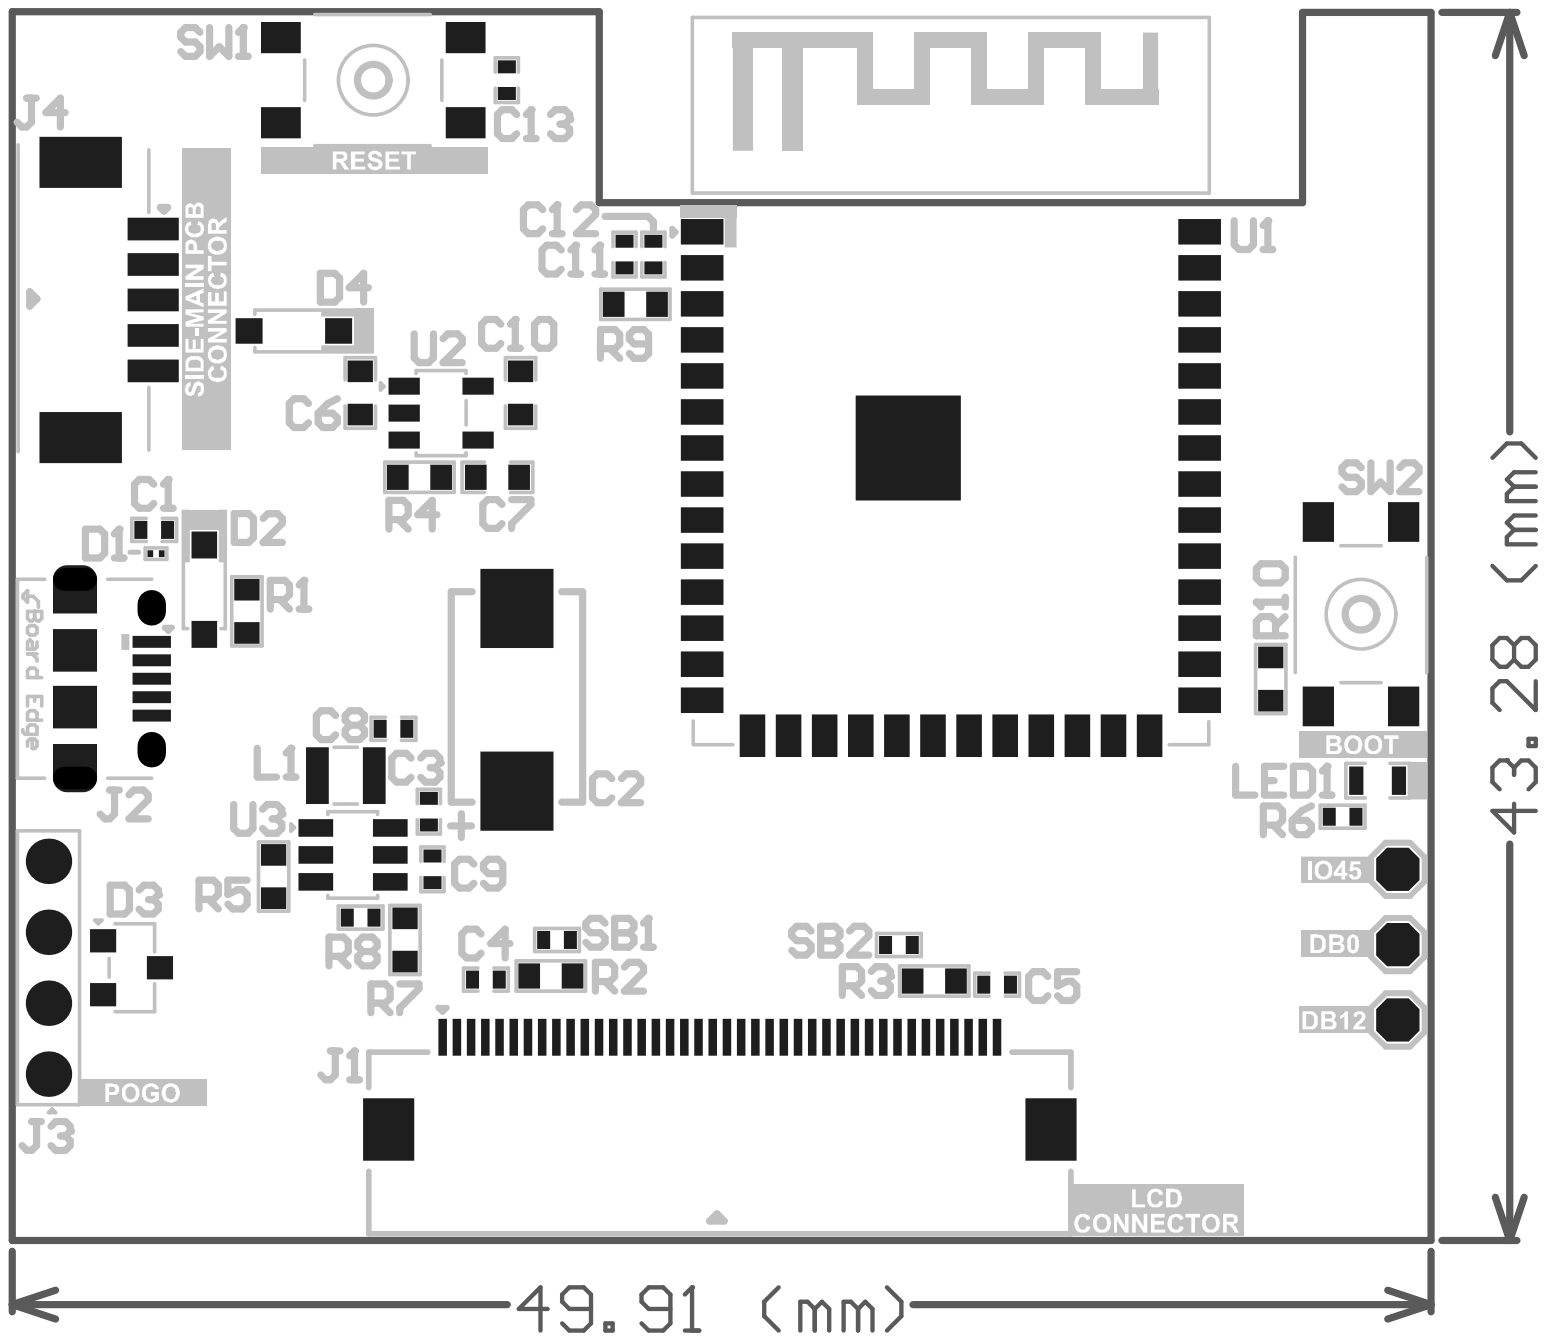
[picture p29: page 1]

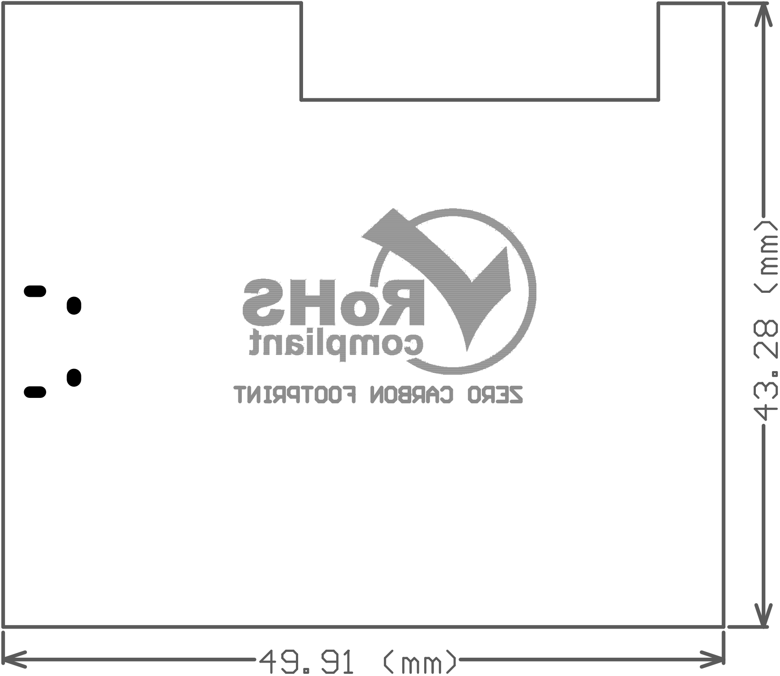
[picture p30: figure]
