eSpark-Backup/ptec-waterdispensingsystem/Deliverables/Main_PCB_Diff_Logo/Main-PCB-v1.0-3/Assembly/Assembly_Drawing.pdf

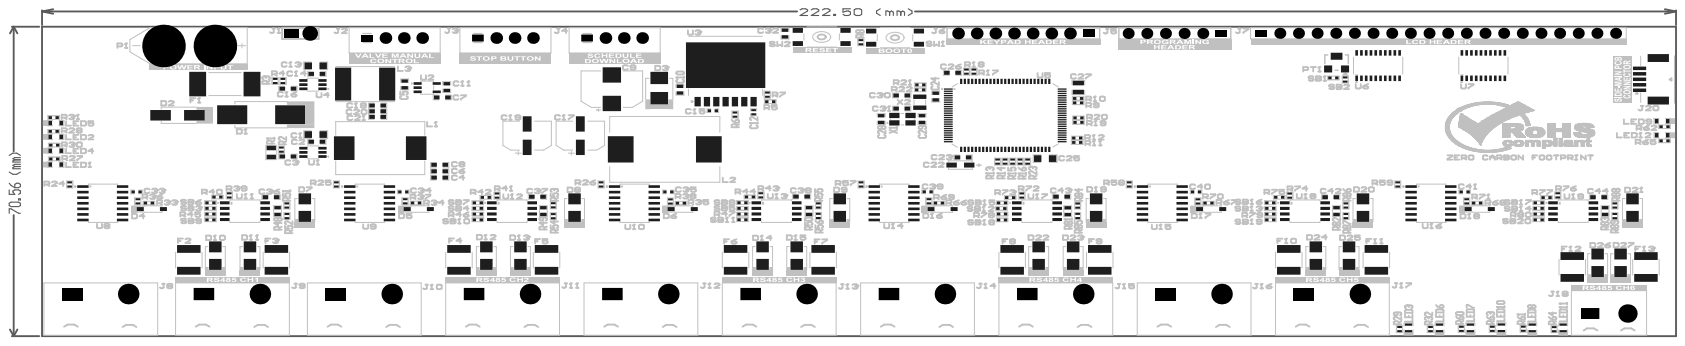
[picture p31: page 1]

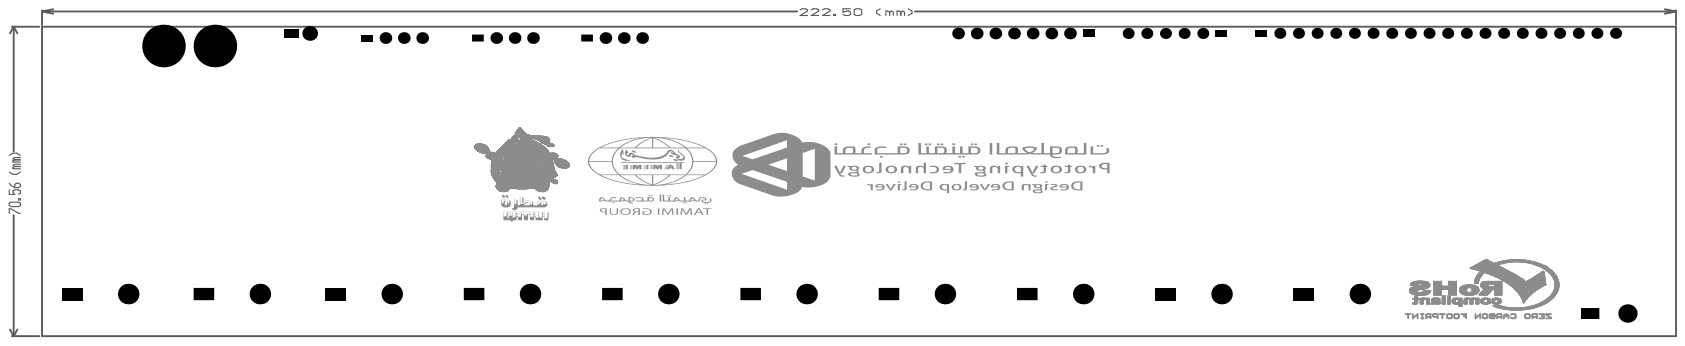
[picture p32: page 2]
