eSpark-Backup/ptec-waterdispensingsystem/Deliverables/Main_PCB_Diff_Logo/Main-PCB-v1.0-1/Assembly/Assembly Drawings.pdf

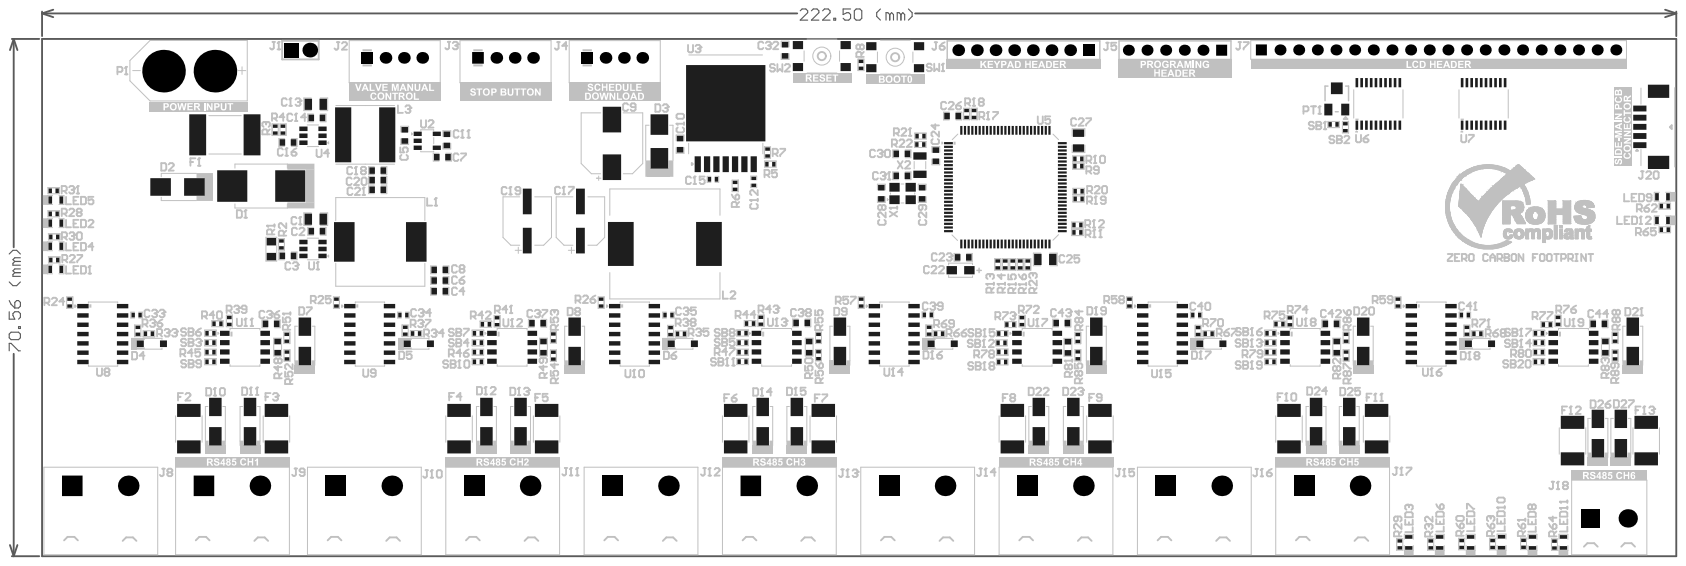
[picture p33: page 1]

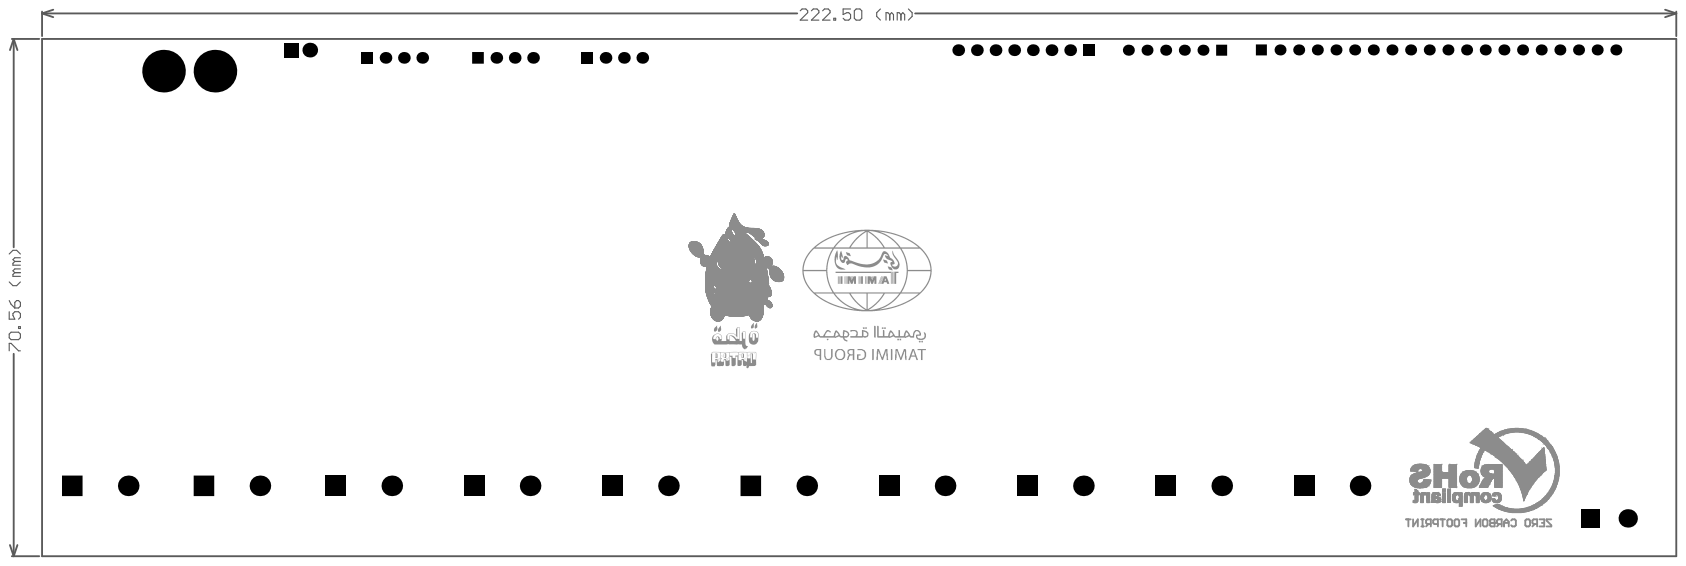
[picture p34: page 2]
