eSpark-Backup/ptec-waterdispensingsystem/Deliverables/Main_PCB_Diff_Logo/Main-PCB-v1.0-2/Assembly/Assembly Drawings.pdf

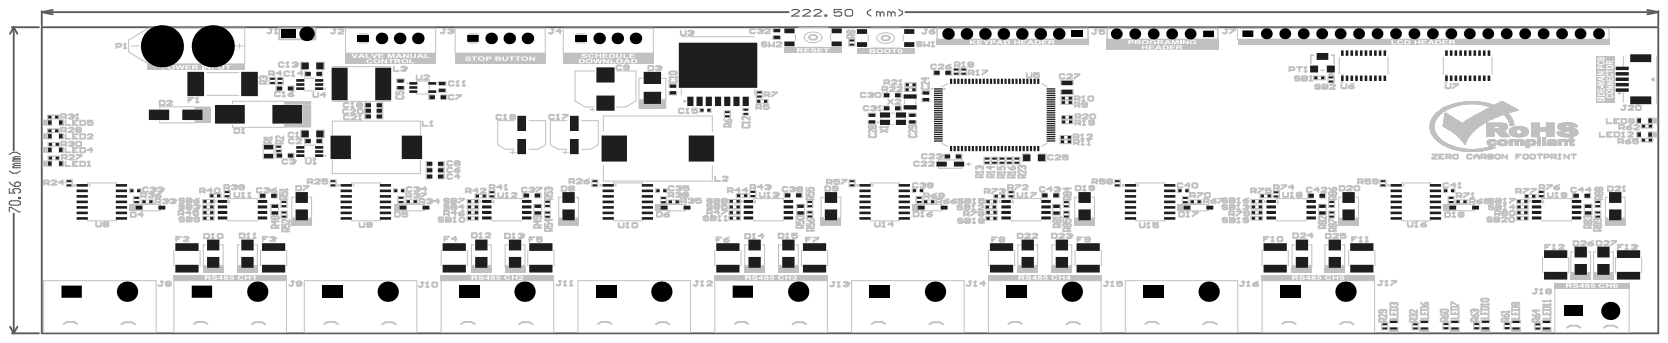
[picture p35: page 1]

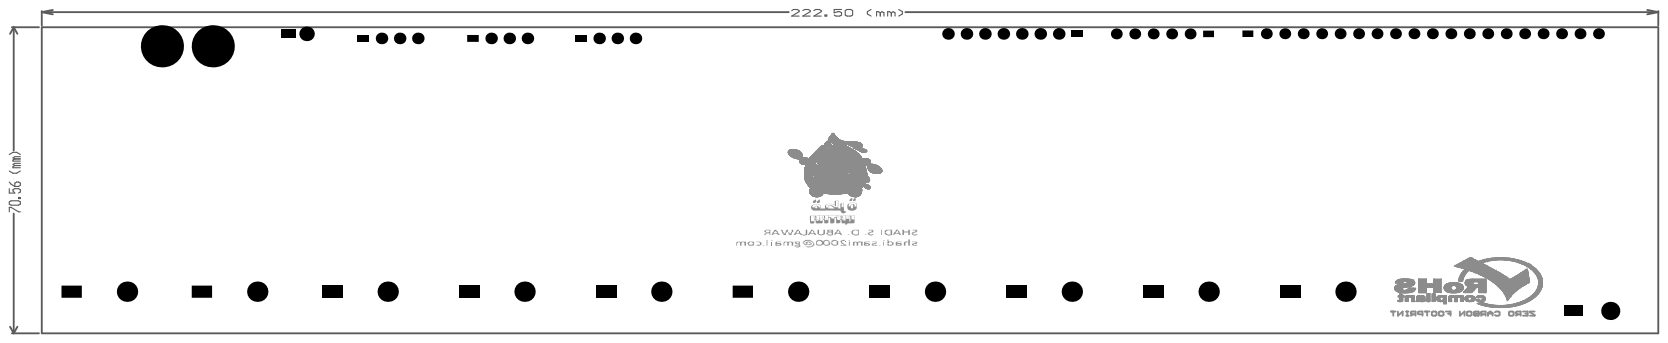
[picture p36: page 2]
