eSpark-Backup/ptec-waterdispensingsystem/(list of files, drawings)

Other design files:
Deliverables/Main_PCB_Diff_Logo/Main-PCB-v1.0-1.PcbDoc
Deliverables/Main_PCB_Diff_Logo/Main-PCB-v1.0-2.PcbDoc
Deliverables/Main_PCB_Diff_Logo/Main-PCB-v1.0-3.PcbDoc
Design Files/Main-PCB-v1.0/Controller-Sheet.SchDoc
Design Files/Main-PCB-v1.0/Main-PCB-v1.0.PcbDoc
Design Files/Main-PCB-v1.0/Main-PCB-v1.0.PrjPcb
Design Files/Main-PCB-v1.0/Power-Sheet.SchDoc
Design Files/Main-PCB-v1.0/RS485-UART.SchDoc
Design Files/Main-PCB-v1.0/Top_Sheet.SchDoc
Design Files/TFT-LCD-Side-PCB-v1.0/Side_PCB.PcbDoc
Design Files/TFT-LCD-Side-PCB-v1.0/TFT-Controller-Sheet.SchDoc
Design Files/TFT-LCD-Side-PCB-v1.0/TFT-LCD-Side-PCB-v1.0.PrjPcb
