eSpark-Backup/ptec-waterdispensingsystem/(commit log)

2023-04-20 TFT-LCD side schematic completed - Main design started
    [Main-PCB-v1.0.PrjPcb, Power-Sheet.SchDoc, TFT-Controller-Sheet.SchDoc, TFT-LCD-Side-PCB-v1.0.PrjPcb]
2023-04-28 #2 Main PCB Completed
    [Controller-Sheet.SchDoc, Main-PCB-v1.0.PrjPcb, Power-Sheet.SchDoc, RS485-UART.SchDoc]
2023-04-28 .gitignore added; notes added #2
    [Controller-Sheet.SchDoc]
2023-04-28 Side PCB Interface connector added #2
    [Controller-Sheet.SchDoc]
2023-04-28 PDF generated for Main and Side PCBs
    [Main-PCB-v1.0.PrjPcb, TFT-LCD-Side-PCB-v1.0.PrjPcb]
2023-05-01 schematic template updated with client logo #2
    [Controller-Sheet.SchDoc, Main-PCB-v1.0.PrjPcb, Power-Sheet.SchDoc, RS485-UART.SchDoc]
2023-05-02 L1 L3 Inductor updated
    [Power-Sheet.SchDoc]
2023-05-09 Parts Placement Power and controller done, RS485 sheet's Placement in Progress #3
    [Controller-Sheet.SchDoc, Main-PCB-v1.0.PcbDoc, Main-PCB-v1.0.PrjPcb, Power-Sheet.SchDoc, RS485-UART.SchDoc]
2023-05-10 Parts Placement completed Some formatting remaining #3
    [Controller-Sheet.SchDoc, Main-PCB-v1.0.PcbDoc, Power-Sheet.SchDoc, RS485-UART.SchDoc]
2023-05-11 #3 Routing in Progress(50% completed)
    [Main-PCB-v1.0.PcbDoc]
2023-05-12 75% Routing completed 147 routes remaining #3
    [Main-PCB-v1.0.PcbDoc, RS485-UART.SchDoc]
2023-05-15 #3 Routing completed
    [Main-PCB-v1.0.PcbDoc, Main-PCB-v1.0.PrjPcb, Power-Sheet.SchDoc]
2023-05-15 #3 Done: Review Done: Minor Changes in Routing.
    [Controller-Sheet.SchDoc, Main-PCB-v1.0.PcbDoc, Main-PCB-v1.0.PrjPcb, Power-Sheet.SchDoc, RS485-UART.SchDoc]
2023-05-16 Top sheet added for Main PCB, PCB part Placement and Routing completed for side #4,Length matching remain for lcd connector
    [Main-PCB-v1.0.PcbDoc, Main-PCB-v1.0.PrjPcb, Side_PCB.PcbDoc, TFT-Controller-Sheet.SchDoc, TFT-LCD-Side-PCB-v1.0.PrjPcb, Top_Sheet.SchDoc]
2023-05-17 #4 Length matching done.
    [Side_PCB.PcbDoc, TFT-Controller-Sheet.SchDoc, TFT-LCD-Side-PCB-v1.0.PrjPcb]
2023-05-17 #3 3D body of inductor and LCD added
    [Controller-Sheet.SchDoc, Main-PCB-v1.0.PcbDoc, Power-Sheet.SchDoc, RS485-UART.SchDoc, Top_Sheet.SchDoc]
2023-06-14 #7 Client logos placed in Main PCBv.1.0-1,2,3 according to ppt.
    [Main-PCB-v1.0-1.PcbDoc, Main-PCB-v1.0-2.PcbDoc, Main-PCB-v1.0-3.PcbDoc, Main-PCB-v1.0.PcbDoc]
2023-06-14 #7 Done: Fresh Deliverables created after adjustments in Logo.
    [Main-PCB-v1.0-1.PcbDoc, Main-PCB-v1.0-2.PcbDoc, Main-PCB-v1.0-3.PcbDoc]
2023-06-15 #7 Deliverables for 3 variants of Main PCB generated
    [Centroid Files.csv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]
2023-06-15 #5 BOM added in Hardware Development-V1.0
    [Client-BOM.xlsx, Client_BOM_v1.0.xlsx, eSpark_BOM-v1.0.xlsx, eSpark_BOM_v1.0.xlsx]
2023-06-15 #4 R7 and C9 change in Schematic and PCB.
    [Side_PCB.PcbDoc, TFT-Controller-Sheet.SchDoc, TFT-LCD-Side-PCB-v1.0.PrjPcb]
2023-06-15 JLCPCB BOM Main PCB complete#5
    [JLCPCB_BOM_v1.0.xlsx]
2023-06-15 #9 Done: Fresh Deliverables update in Deliverables folder.
    [Centroid File.csv, Centroid Files.csv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]
2023-06-19 Fresh Deliverables Generated for V1.0-3 after resizing Ptec logo 7
    [Centroid Files.csv, Centroid.csv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]
